KVR-CIBER/arachne-18/cad/brain_mini/fab/arachne_mini_BOM_JLCPCB.csv

Comment | Designator | Footprint | Quantity | MPN / note | LCSC Part #
AOD4185 | Q1 | TO-252-2 | 1 | AOD4185 (P-MOSFET 40 V 40 A, reverse polarity) | C400894
10k | R1,R11,R12,R17,R18,R21,R22 | R_0603_1608Metric | 7 | 0603 10k 1% | C25804
330u 25V | C1,C2 | CP_Elec_8x10.5 | 2 | 330uF 25V 8x10.5 alu, STRONGLY recommended for the servo current peaks | C350008
10u 25V / 10u | C3,C5,C6,C14 | C_0805_2012Metric | 4 | 0805 10u 25V X5R ceramic | C15850
100k | R2,R5 | R_0603_1608Metric | 2 | 0603 100k 1% | C25803
15k | R3,R9 | R_0603_1608Metric | 2 | 0603 15k 1% | C22809
100n | C4,C7,C8,C16,C18,C20,C21,C22,C23,C24,C26 | C_0603_1608Metric | 11 | 0603 100n X7R ceramic | C14663
TPS54560B | U1 | Texas_R-PDSO-G8_EP2.95x4.9mm_Mask2.4x3.1mm_ThermalVias | 1 | TPS54560BDDAR | C1850354
470k | R4 | R_0603_1608Metric | 1 | 0603 470k 1% | C23178
220k | R6 | R_0603_1608Metric | 1 | 0603 220k 1% | C22961
6.8u | L1 | L_Bourns_SRP1038C_10.0x10.0mm | 1 | Bourns SRP1038C-6R8M (6.8 uH, >= 8 A) | C20804570
SS54 | D4 | D_SMA | 1 | SS54 (5 A 40 V Schottky, JLC basic) | C22452
47u 10V | C9,C10,C11 | C_1206_3216Metric | 3 | 1206 47u 10V X5R ceramic | C96123
27k | R7 | R_0603_1608Metric | 1 | 0603 27k 1% | C22967
5k1 | R8,R27,R28 | R_0603_1608Metric | 3 | 0603 5k1 1% | C23186
4n7 | C12 | C_0603_1608Metric | 1 | 0603 4n7 X5R ceramic | C53987
47p | C13 | C_0603_1608Metric | 1 | 0603 47p X7R ceramic | C1671
LED 5V / LED ESP | D5,D8 | LED_0603_1608Metric | 2 | LED 0603 red (JLC basic) | C2286
2k2 | R10 | R_0603_1608Metric | 1 | 0603 2k2 1% | C4190
SS14 | D6,D7 | D_SMA | 2 | SS14 | C2480
AMS1117-3.3 | U2 | SOT-223-3_TabPin2 | 1 | AMS1117-3.3 | C6186
22u | C15,C17 | C_0805_2012Metric | 2 | 0805 22u X5R ceramic | C45783
ESP32-S3-WROOM-1-N16R8 | U3 | ESP32-S3-WROOM-1 | 1 | ESP32-S3-WROOM-1-N16R8 | C2913202
1k | R15,R19,R23 | R_0603_1608Metric | 3 | 0603 1k 1% | C21190
1u | C19,C29 | C_0603_1608Metric | 2 | 0603 1u X5R ceramic | C15849
74AHCT1G126 | U4,U6 | SOT-23-5 | 2 | 74AHCT1G126GW (TX driver, 5 V out) | C163712
74LVC1G34 | U5,U7 | SOT-23-5 | 2 | 74LVC1G34GW (RX buffer, 5 V tolerant) | C840096
47 | R16,R20 | R_0603_1608Metric | 2 | 0603 47 1% | C23182
L1 servo / L2 servo / L3 servo / L4 servo / L5 servo / L6 servo | J2,J3,J4,J5,J6,J7 | Molex_5267-03A_1x03_P2.50mm_Vertical | 6 | Molex 22-03-5035 / 5267-03A Mini-SPOX (mates with the 5264 plug on Feetech cables), LCSC C45581067 | C45581067
LSM6DS3TR-C | U8 | LGA-14_3x2.5mm_P0.5mm_LayoutBorder3x4y | 1 | LSM6DS3TR-C (6-axis IMU, I2C 0x6A) | C967633
4k7 | R24,R25 | R_0603_1608Metric | 2 | 0603 4k7 1% | C23162
USB-C PI | J8 | USB_C_Receptacle_HRO_TYPE-C-31-M-12 | 1 | HRO TYPE-C-31-M-12 | C165948
