KVR-CIBER/arachne-18/cad/electronics_plate/electronics_plate_v6.dxf

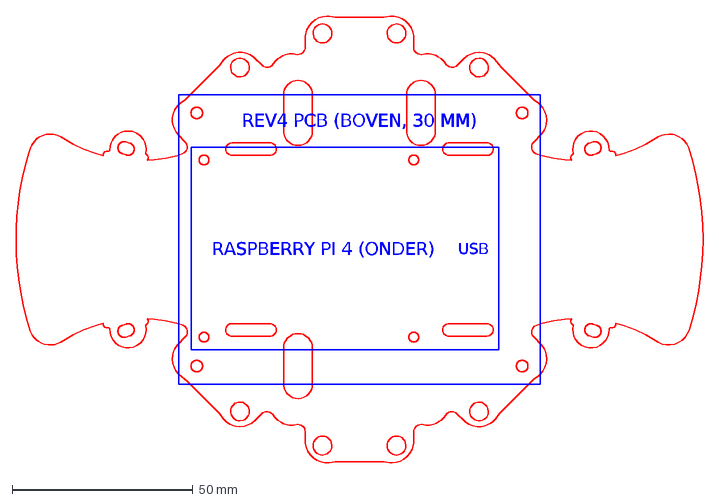
[picture p4: CAD file, 2026-11-08]
cad/electronics_plate/electronics_plate_v6.dxf
REV4 PCB (BOVEN, 30 MM)
RASPBERRY PI 4 (ONDER)
USB
