KVR-CIBER/arachne-18/cad/brain_mini/arachne_mini.kicad_pcb

## KiCad design cad/brain_mini/arachne_mini.kicad_pcb (2026-11-08)

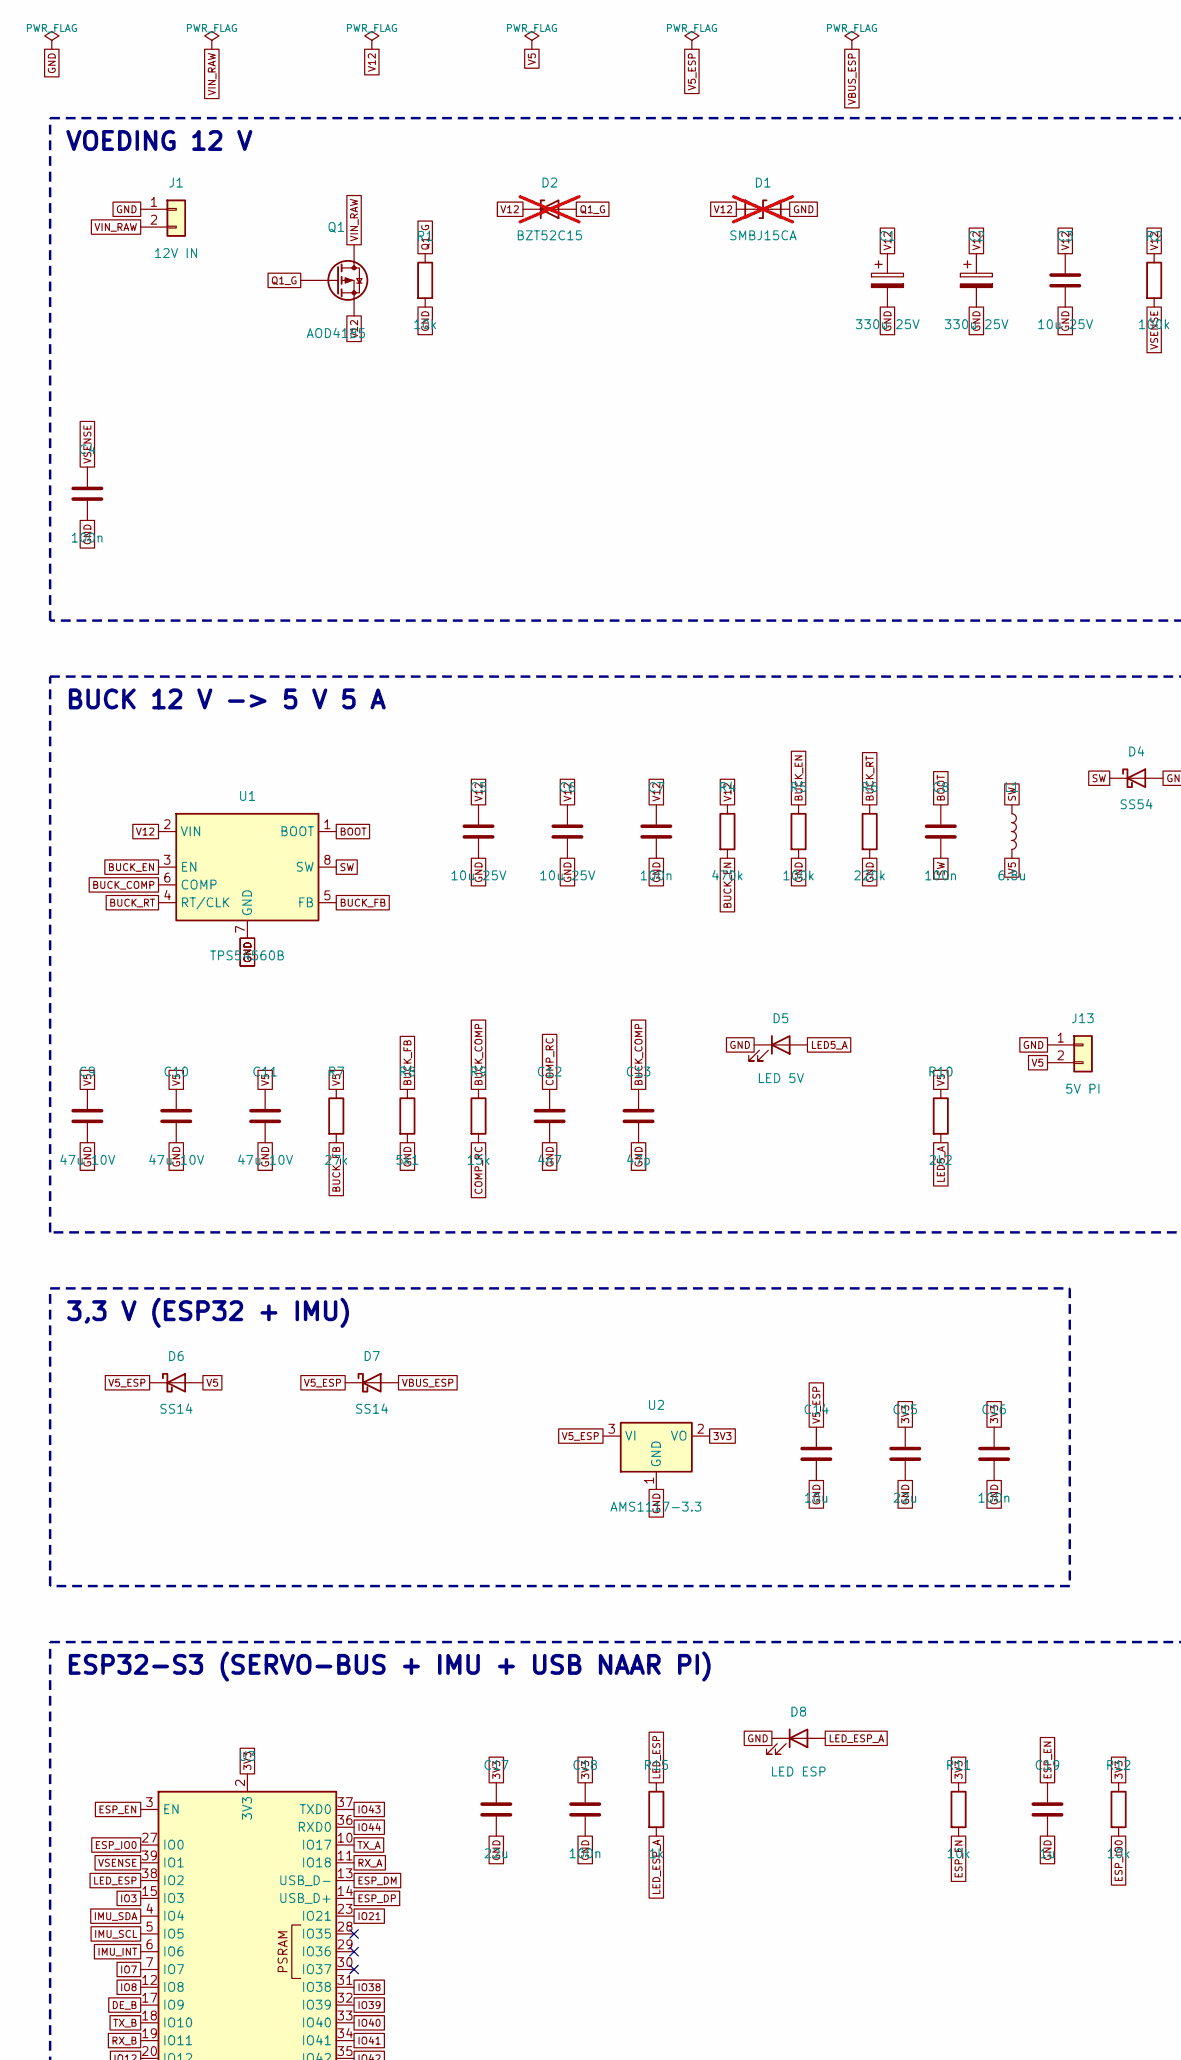
[picture p6: schematic arachne_mini.kicad_sch, ARACHNE-18 mini brain board, part in row 1, column 1]

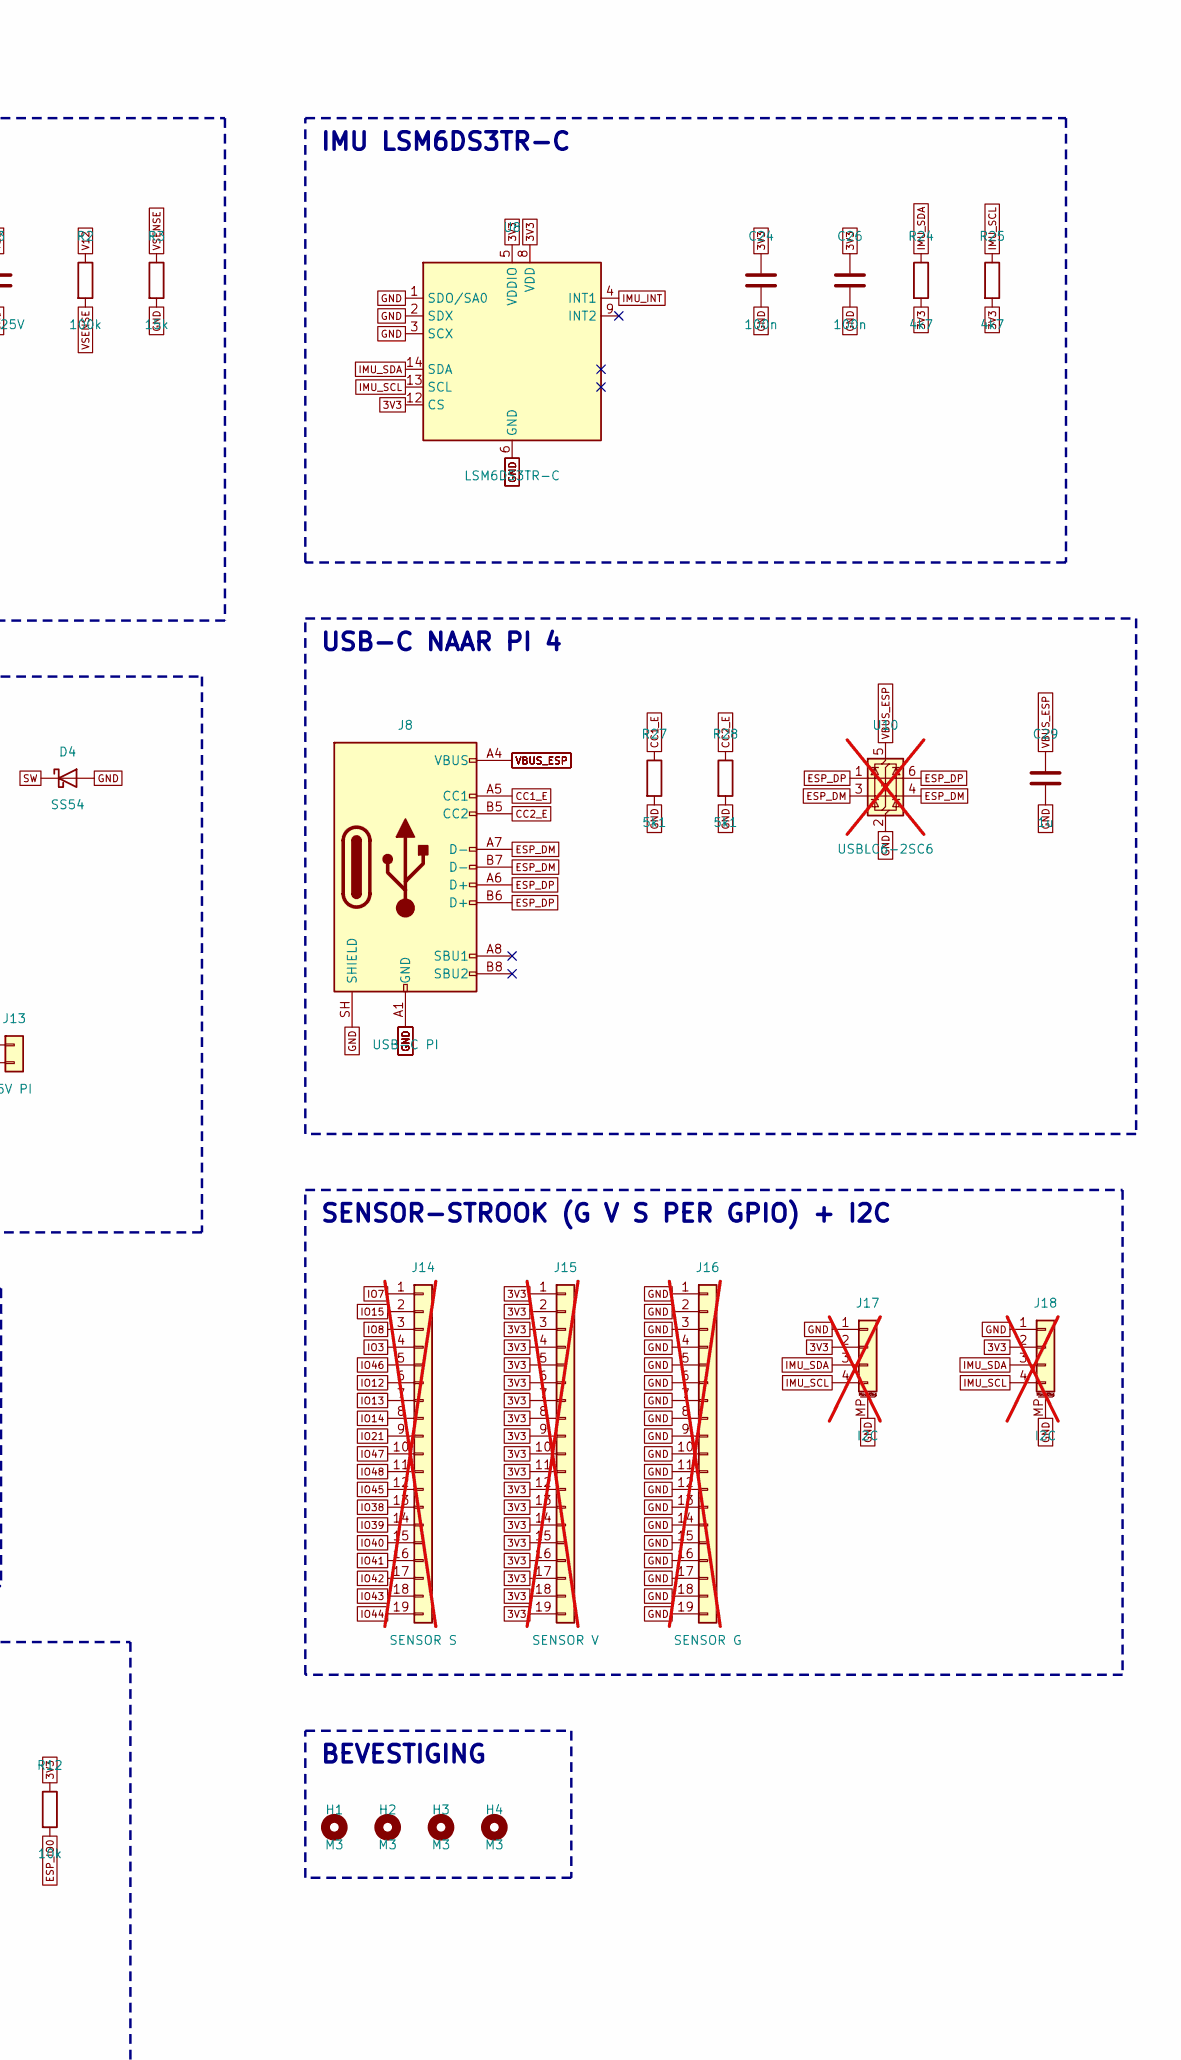
[picture p7: schematic arachne_mini.kicad_sch, ARACHNE-18 mini brain board, part in row 1, column 2]

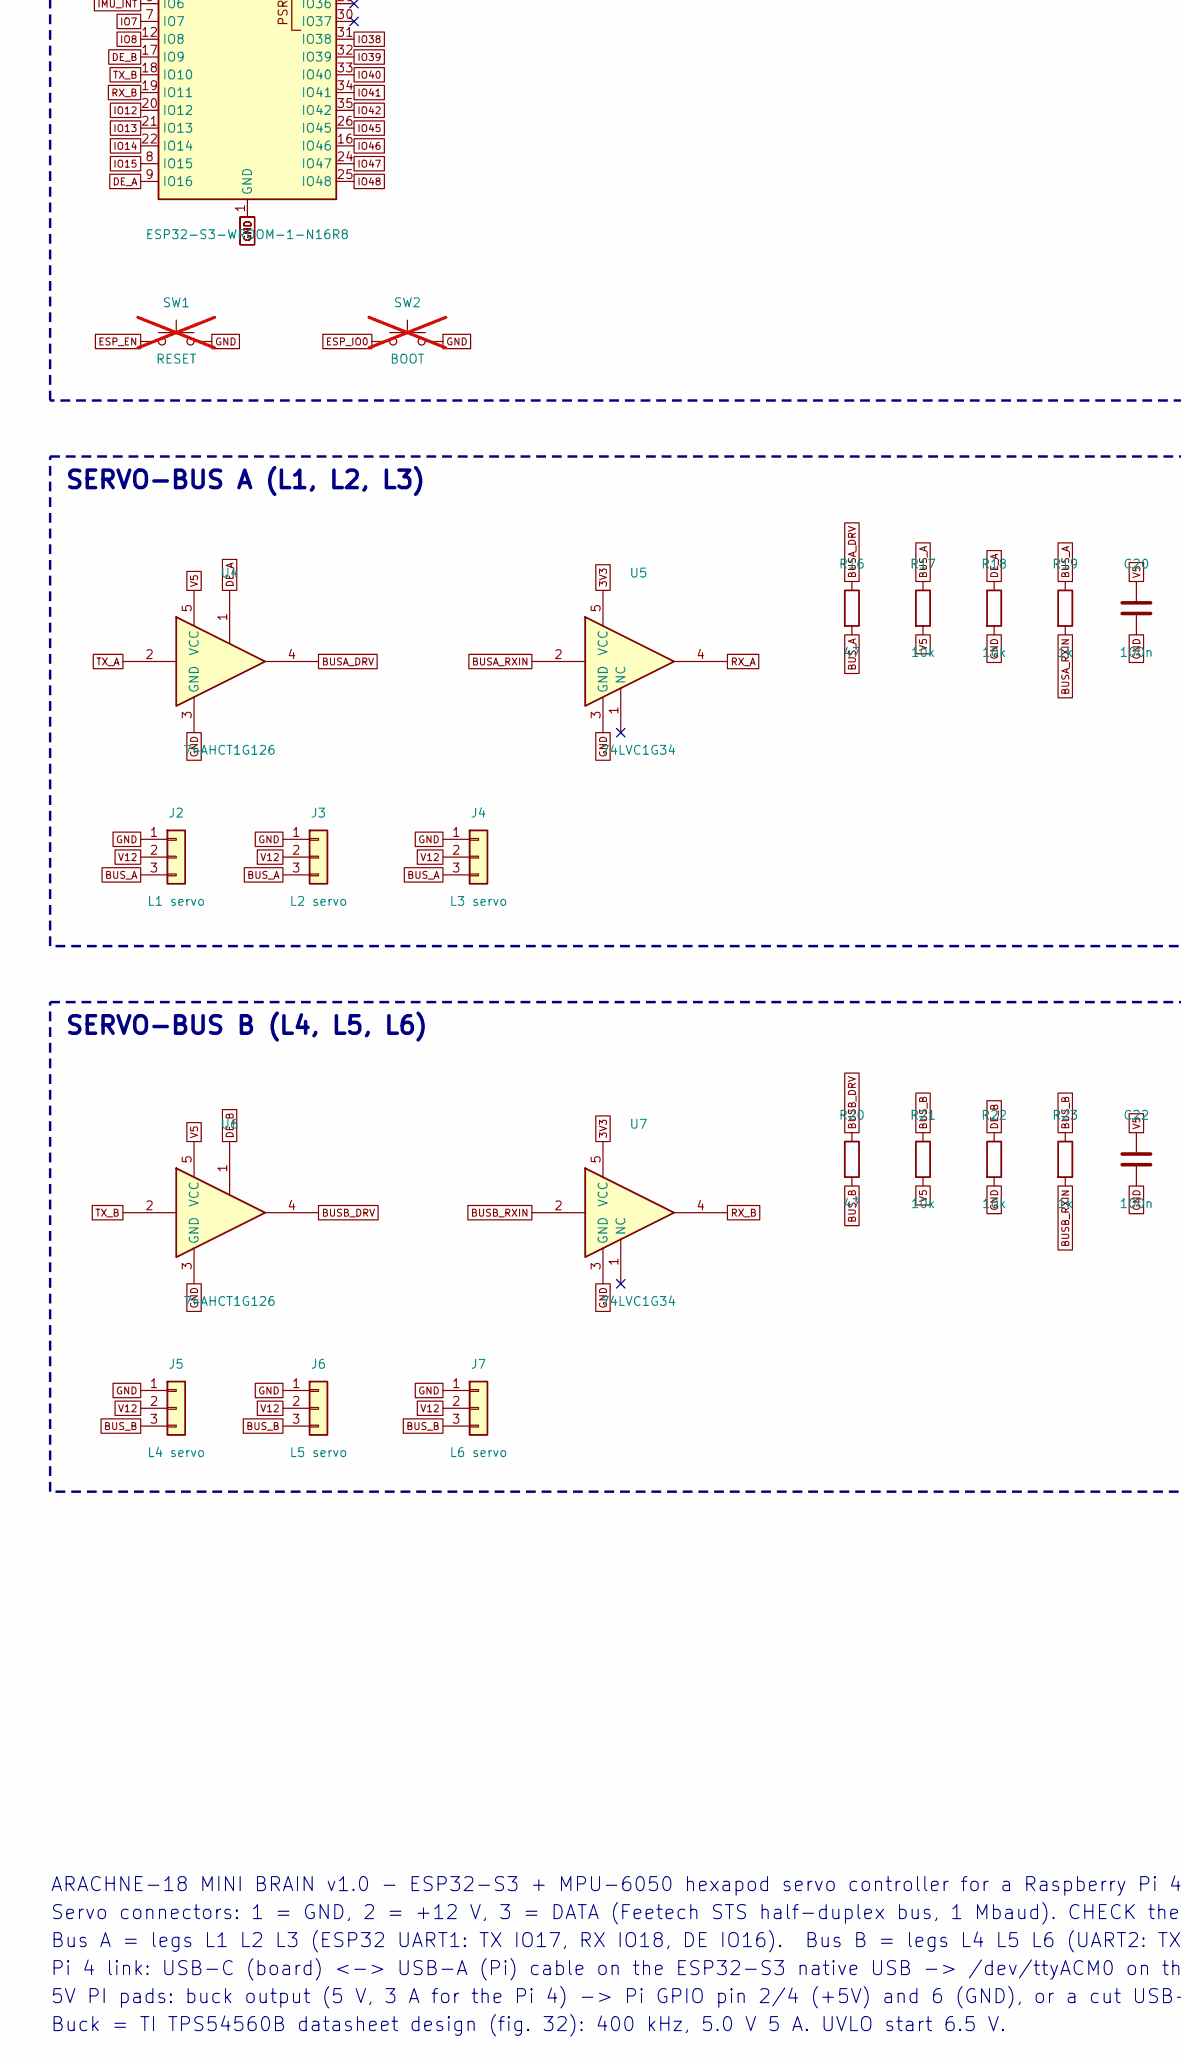
[picture p8: schematic arachne_mini.kicad_sch, ARACHNE-18 mini brain board, part in row 2, column 1]

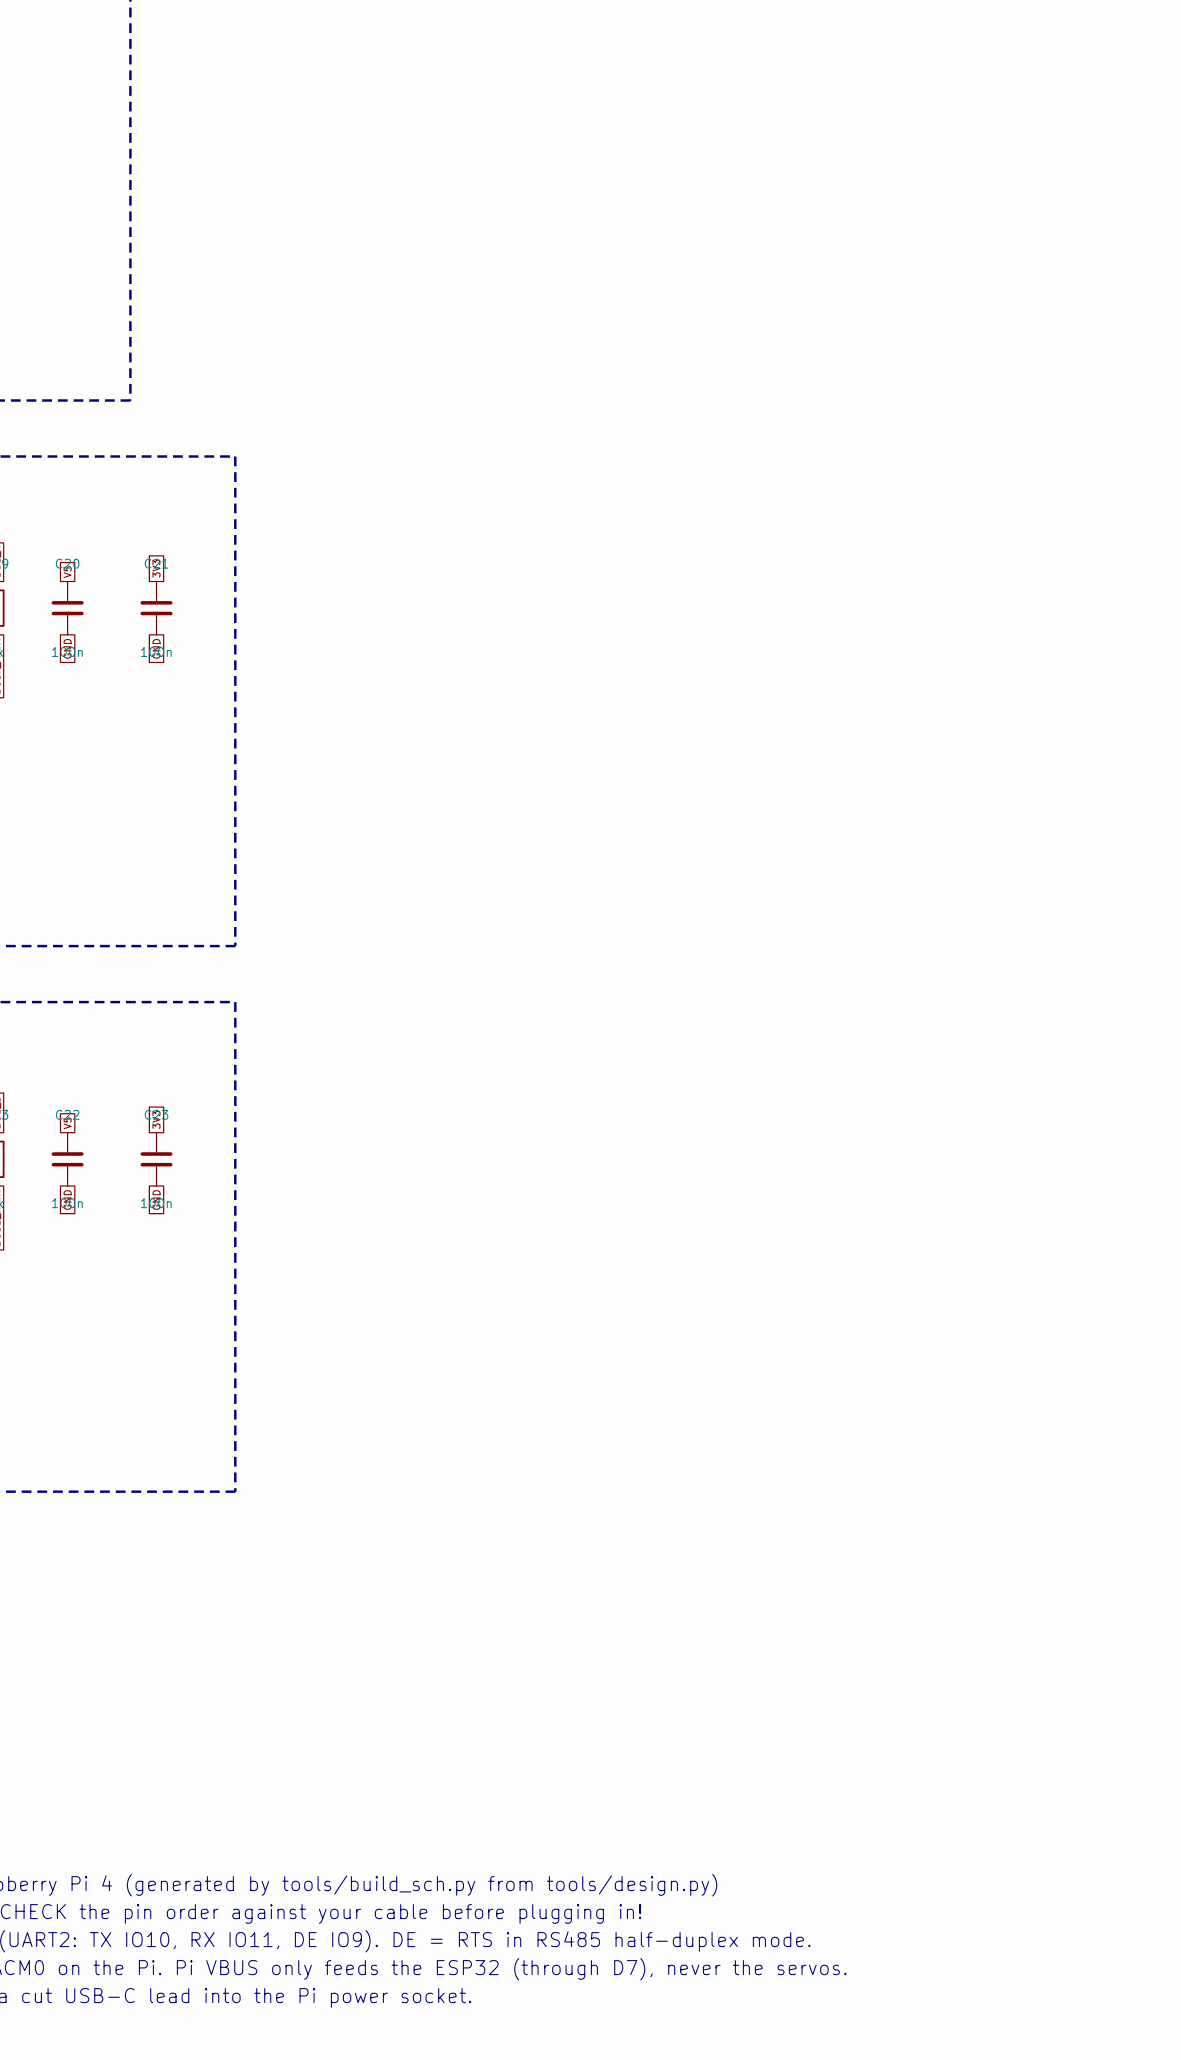
[picture p9: schematic arachne_mini.kicad_sch, ARACHNE-18 mini brain board, part in row 2, column 2]

Parts:
C1, C2: 330u 25V; CP_Elec_8x10.5; MPN 330uF 25V 8x10.5 alu, STRONGLY recommen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
C3, C5, C6: 10u 25V; C_0805_2012Metric; MPN 0805 10u 25V X5R ceramic
C4, C7, C8, C16, C18, C20, C21, C22, C23, C24, C26: 100n; C_0603_1608Metric; MPN 0603 100n X7R ceramic
C9, C10, C11: 47u 10V; C_1206_3216Metric; MPN 1206 47u 10V X5R ceramic
C12: 4n7; C_0603_1608Metric; MPN 0603 4n7 X5R ceramic
C13: 47p; C_0603_1608Metric; MPN 0603 47p X7R ceramic
C14: 10u; C_0805_2012Metric; MPN 0805 10u X5R ceramic
C15, C17: 22u; C_0805_2012Metric; MPN 0805 22u X5R ceramic
C19, C29: 1u; C_0603_1608Metric; MPN 0603 1u X5R ceramic
D1: SMBJ15CA; D_SMB; MPN SMBJ15CA TVS (optional); not fitted
D2: BZT52C15; D_SOD-123; MPN BZT52C15 gate clamp (optional: AOD4185 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; not fitted
D4: SS54; D_SMA; MPN SS54 (5 A 40 V Schottky, JLC basic)
D5: LED 5V; LED_0603_1608Metric; MPN LED 0603 red (JLC basic)
D6, D7: SS14; D_SMA; MPN SS14
D8: LED ESP; LED_0603_1608Metric; MPN LED 0603 red (JLC basic)
H1, H2, H3, H4: M3; MountingHole_3.2mm_M3
J1: 12V IN; SolderWire_2pad_P7mm_D2.2mm; MPN solder pads for 14-16 AWG
J2: L1 servo; Molex_5267-03A_1x03_P2.50mm_Vertical; MPN Molex 22-03-5035 / 5267-03A Mini-SPOX (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
J3: L2 servo; Molex_5267-03A_1x03_P2.50mm_Vertical; MPN Molex 22-03-5035 / 5267-03A Mini-SPOX (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
J4: L3 servo; Molex_5267-03A_1x03_P2.50mm_Vertical; MPN Molex 22-03-5035 / 5267-03A Mini-SPOX (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
J5: L4 servo; Molex_5267-03A_1x03_P2.50mm_Vertical; MPN Molex 22-03-5035 / 5267-03A Mini-SPOX (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
J6: L5 servo; Molex_5267-03A_1x03_P2.50mm_Vertical; MPN Molex 22-03-5035 / 5267-03A Mini-SPOX (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
J7: L6 servo; Molex_5267-03A_1x03_P2.50mm_Vertical; MPN Molex 22-03-5035 / 5267-03A Mini-SPOX (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
J8: USB-C PI; USB_C_Receptacle_HRO_TYPE-C-31-M-12; MPN HRO TYPE-C-31-M-12
J13: 5V PI; SolderWire_2pad_P5mm_D1.6mm_5V; MPN solder pads: 5 V 3 A to the Pi 4 (GPIO 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
J14: SENSOR S; PinHeader_1x19_P2.54mm_Vertical; MPN 1x19 pin header 2.54 mm (row S of the s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; not fitted
J15: SENSOR V; PinHeader_1x19_P2.54mm_Vertical; MPN 1x19 pin header 2.54 mm (row V of the s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; not fitted
J16: SENSOR G; PinHeader_1x19_P2.54mm_Vertical; MPN 1x19 pin header 2.54 mm (row G of the s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; not fitted
J17, J18: I2C; JST_SH_SM04B-SRSS-TB_1x04-1MP_P1.00mm_Horizontal; MPN JST SM04B-SRSS-TB (Qwiic / STEMMA QT, o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; not fitted
L1: 6.8u; L_Bourns_SRP1038C_10.0x10.0mm; MPN Bourns SRP1038C-6R8M (6.8 uH, >= 8 A)
Q1: AOD4185; TO-252-2; MPN AOD4185 (P-MOSFET 40 V 40 A, reverse po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
R1, R11, R12, R17, R18, R21, R22: 10k; R_0603_1608Metric; MPN 0603 10k 1%
R2, R5: 100k; R_0603_1608Metric; MPN 0603 100k 1%
R3, R9: 15k; R_0603_1608Metric; MPN 0603 15k 1%
R4: 470k; R_0603_1608Metric; MPN 0603 470k 1%
R6: 220k; R_0603_1608Metric; MPN 0603 220k 1%
R7: 27k; R_0603_1608Metric; MPN 0603 27k 1%
R8, R27, R28: 5k1; R_0603_1608Metric; MPN 0603 5k1 1%
R10: 2k2; R_0603_1608Metric; MPN 0603 2k2 1%
R15, R19, R23: 1k; R_0603_1608Metric; MPN 0603 1k 1%
R16, R20: 47; R_0603_1608Metric; MPN 0603 47 1%
R24, R25: 4k7; R_0603_1608Metric; MPN 0603 4k7 1%
SW1: RESET; SW_Push_1P1T_NO_CK_KMR2; MPN CK KMR221G (4.2x2.8 tact); the S3 flash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; not fitted
SW2: BOOT; SW_Push_1P1T_NO_CK_KMR2; MPN CK KMR221G (4.2x2.8 tact); the S3 flash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; not fitted
U1: TPS54560B; Texas_R-PDSO-G8_EP2.95x4.9mm_Mask2.4x3.1mm_ThermalVias; MPN TPS54560BDDAR
U2: AMS1117-3.3; SOT-223-3_TabPin2; MPN AMS1117-3.3
U3: ESP32-S3-WROOM-1-N16R8; ESP32-S3-WROOM-1; MPN ESP32-S3-WROOM-1-N16R8
U4, U6: 74AHCT1G126; SOT-23-5; MPN 74AHCT1G126GW (TX driver, 5 V out)
U5, U7: 74LVC1G34; SOT-23-5; MPN 74LVC1G34GW (RX buffer, 5 V tolerant)
U8: LSM6DS3TR-C; LGA-14_3x2.5mm_P0.5mm_LayoutBorder3x4y; MPN LSM6DS3TR-C (6-axis IMU, I2C 0x6A)
U10: USBLC6-2SC6; SOT-23-6; MPN USBLC6-2SC6 ESD (optional); not fitted

Connections:
3V3: C15.1, C16.1, C17.1, C18.1, C21.1, C23.1, C24.1, C26.1, J15.1, J15.2, J15.3, J15.4, J15.5, J15.6, J15.7, J15.8, J15.9, J15.10, J15.11, J15.12, J15.13, J15.14, J15.15, J15.16, J15.17, J15.18, J15.19, J17.2, J18.2, R11.1, R12.1, R24.2, R25.2, U2.2 (VO), U3.2 (3V3), U5.5 (VCC), U7.5 (VCC), U8.5 (VDDIO), U8.8 (VDD), U8.12 (CS)
BOOT: C8.1, U1.1 (BOOT)
BUCK_COMP: C13.1, R9.1, U1.6 (COMP)
BUCK_EN: R4.2, R5.1, U1.3 (EN)
BUCK_FB: R7.2, R8.1, U1.5 (FB)
BUCK_RT: R6.1, U1.4 (RT/CLK)
BUSA_DRV: R16.1, U4.4
BUSA_RXIN: R19.2, U5.2
BUSB_DRV: R20.1, U6.4
BUSB_RXIN: R23.2, U7.2
BUS_A: J2.3, J3.3, J4.3, R16.2, R17.1, R19.1
BUS_B: J5.3, J6.3, J7.3, R20.2, R21.1, R23.1
CC1_E: J8.A5 (CC1), R27.1
CC2_E: J8.B5 (CC2), R28.1
COMP_RC: C12.1, R9.2
DE_A: R18.1, U3.9 (IO16), U4.1
DE_B: R22.1, U3.17 (IO9), U6.1
ESP_DM: J8.A7 (D-), J8.B7 (D-), U3.13 (USB_D-), U10.3 (I/O2), U10.4 (I/O2)
ESP_DP: J8.A6 (D+), J8.B6 (D+), U3.14 (USB_D+), U10.1 (I/O1), U10.6 (I/O1)
ESP_EN: C19.1, R11.2, SW1.1, U3.3 (EN)
ESP_IO0: R12.2, SW2.1, U3.27 (IO0)
GND: C1.2, C2.2, C3.2, C4.2, C5.2, C6.2, C7.2, C9.2, C10.2, C11.2, C12.2, C13.2, C14.2, C15.2, C16.2, C17.2, C18.2, C19.2, C20.2, C21.2, C22.2, C23.2, C24.2, C26.2, C29.2, D1.2 (A2), D4.2 (A), D5.1 (K), D8.1 (K), J1.1, J2.1, J3.1, J4.1, J5.1, J6.1, J7.1, J8.A1 (GND), J8.A12 (GND), J8.B1 (GND), J8.B12 (GND), J8.SH (SHIELD), J13.1, J16.1, J16.2, J16.3, J16.4, J16.5, J16.6, J16.7, J16.8, J16.9, J16.10, J16.11, J16.12, J16.13, J16.14, J16.15, J16.16, J16.17, J16.18, J16.19, J17.1, J17.MP (MountPin), J18.1, J18.MP (MountPin), R1.2, R3.2, R5.2, R6.2, R8.2, R18.2, R22.2, R27.2, R28.2, SW1.2, SW2.2, U1.7 (GND), U1.9 (GND), U2.1 (GND), U3.1 (GND), U3.40 (GND), U3.41 (GND), U4.3 (GND), U5.3 (GND), U6.3 (GND), U7.3 (GND), U8.1 (SDO/SA0), U8.2 (SDX), U8.3 (SCX), U8.6 (GND), U8.7 (GND), U10.2 (GND)
IMU_INT: U3.6 (IO6), U8.4 (INT1)
IMU_SCL: J17.4, J18.4, R25.1, U3.5 (IO5), U8.13 (SCL)
IMU_SDA: J17.3, J18.3, R24.1, U3.4 (IO4), U8.14 (SDA)
IO3: J14.4, U3.15 (IO3)
IO7: J14.1, U3.7 (IO7)
IO8: J14.3, U3.12 (IO8)
IO12: J14.6, U3.20 (IO12)
IO13: J14.7, U3.21 (IO13)
IO14: J14.8, U3.22 (IO14)
IO15: J14.2, U3.8 (IO15)
IO21: J14.9, U3.23 (IO21)
IO38: J14.13, U3.31 (IO38)
IO39: J14.14, U3.32 (IO39)
IO40: J14.15, U3.33 (IO40)
IO41: J14.16, U3.34 (IO41)
IO42: J14.17, U3.35 (IO42)
IO43: J14.18, U3.37 (TXD0)
IO44: J14.19, U3.36 (RXD0)
IO45: J14.12, U3.26 (IO45)
IO46: J14.5, U3.16 (IO46)
IO47: J14.10, U3.24 (IO47)
IO48: J14.11, U3.25 (IO48)
LED5_A: D5.2 (A), R10.2
LED_ESP: R15.1, U3.38 (IO2)
LED_ESP_A: D8.2 (A), R15.2
Q1_G: D2.2 (A), Q1.1 (G), R1.1
RX_A: U3.11 (IO18), U5.4
RX_B: U3.19 (IO11), U7.4
SW: C8.2, D4.1 (K), L1.1, U1.8 (SW)
TX_A: U3.10 (IO17), U4.2
TX_B: U3.18 (IO10), U6.2
V5: C9.1, C10.1, C11.1, C20.1, C22.1, D6.2 (A), J13.2, L1.2, R7.1, R10.1, R17.2, R21.2, U4.5 (VCC), U6.5 (VCC)
V5_ESP: C14.1, D6.1 (K), D7.1 (K), U2.3 (VI)
V12: C1.1, C2.1, C3.1, C5.1, C6.1, C7.1, D1.1 (A1), D2.1 (K), J2.2, J3.2, J4.2, J5.2, J6.2, J7.2, Q1.3 (S), R2.1, R4.1, U1.2 (VIN)
VBUS_ESP: C29.1, D7.2 (A), J8.A4 (VBUS), J8.A9 (VBUS), J8.B4 (VBUS), J8.B9 (VBUS), U10.5 (VBUS)
VIN_RAW: J1.2, Q1.2 (D)
VSENSE: C4.1, R2.2, R3.1, U3.39 (IO1)

Notes on the sheet:
VOEDING 12 V
BUCK 12 V -> 5 V 5 A
3,3 V (ESP32 + IMU)
ESP32-S3 (SERVO-BUS + IMU + USB NAAR PI)
SERVO-BUS A (L1, L2, L3)
SERVO-BUS B (L4, L5, L6)
IMU LSM6DS3TR-C
USB-C NAAR PI 4
SENSOR-STROOK (G V S PER GPIO) + I2C
BEVESTIGING
ARACHNE-18 MINI BRAIN v1.0 - ESP32-S3 + MPU-6050 hexapod servo controller for a Raspberry Pi 4 (generated by tools/build_sch.py from tools/design.py)
Servo connectors: 1 = GND, 2 = +12 V, 3 = DATA (Feetech STS half-duplex bus, 1 Mbaud). CHECK the pin order against your cable before plugging in!
Bus A = legs L1 L2 L3 (ESP32 UART1: TX IO17, RX IO18, DE IO16). Bus B = legs L4 L5 L6 (UART2: TX IO10, RX IO11, DE IO9). DE = RTS in RS485 half-duplex mode.
Pi 4 link: USB-C (board) <-> USB-A (Pi) cable on the ESP32-S3 native USB -> /dev/ttyACM0 on the Pi. Pi VBUS only feeds the ESP32 (through D7), never the servos.
5V PI pads: buck output (5 V, 3 A for the Pi 4) -> Pi GPIO pin 2/4 (+5V) and 6 (GND), or a cut USB-C lead into the Pi power socket.
Buck = TI TPS54560B datasheet design (fig. 32): 400 kHz, 5.0 V 5 A. UVLO start 6.5 V.

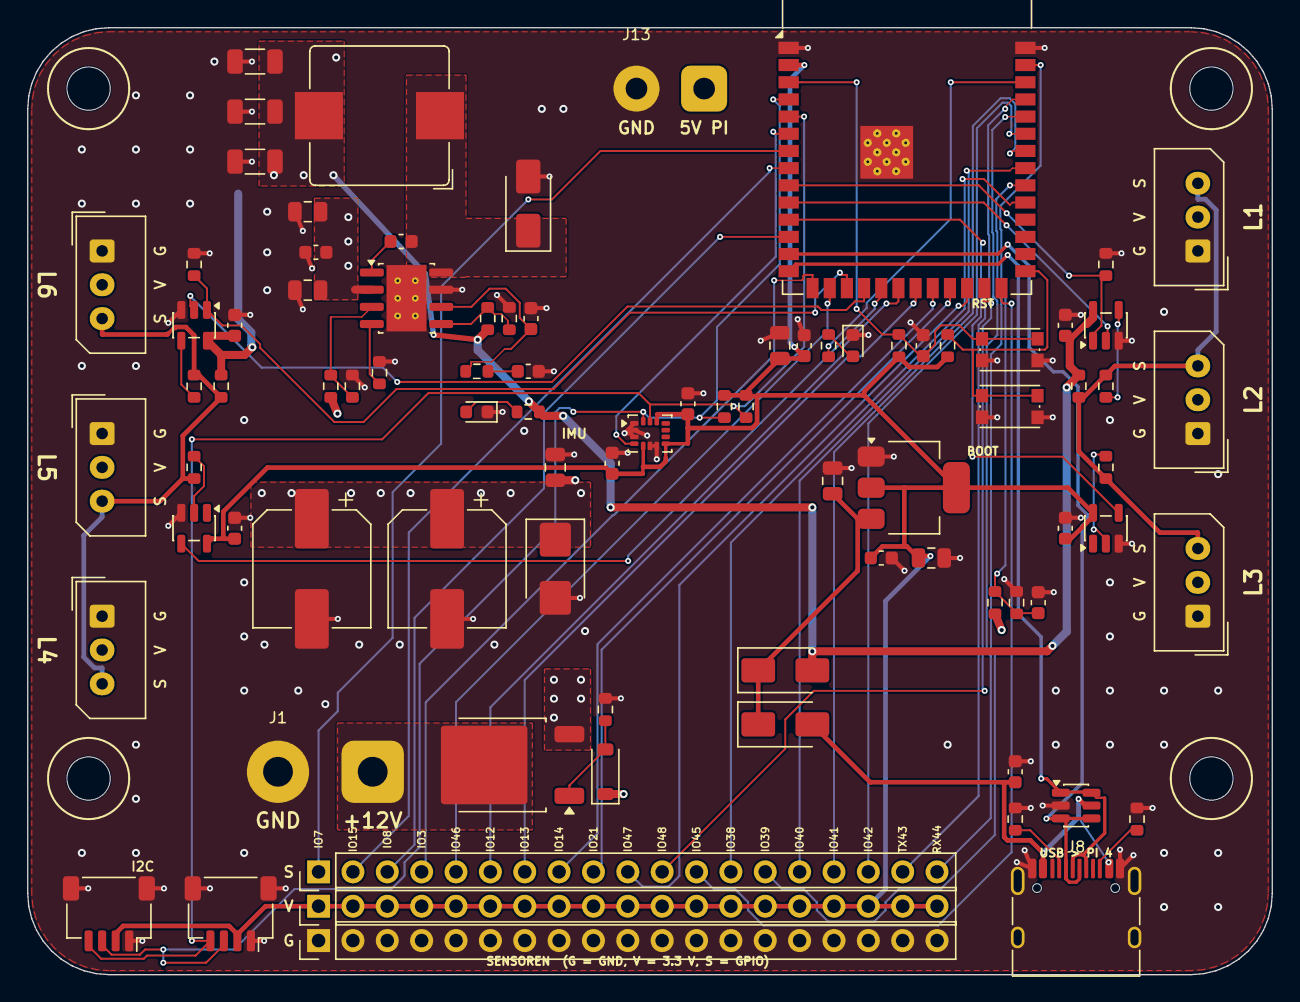
[picture p10: board arachne_mini.kicad_pcb from above]

Board: 4 copper layers, 92.0 x 70.0 mm, 89 parts (0 on the bottom side), 59 nets.
