KVR-CIBER/arachne-18/(commit log)

2026-11-08 brain_mini: sensor headers J14-J16 placed by JLC (C2932706, THT), everything on the board; rotation rule for 1xN headers
    [arachne_mini-B_Cu.gbr, arachne_mini-B_Mask.gbr, arachne_mini-B_Paste.gbr, arachne_mini-B_Silkscreen.gbr, arachne_mini-Edge_Cuts.gbr, arachne_mini-F_Cu.gbr, arachne_mini-F_Mask.gbr, arachne_mini-F_Paste.gbr]
2026-11-08 brain_mini: cheapest JLC order - optional parts (D1 D2 U10 J17 J18 SW1 SW2) and sensor headers J14-J16 hand-solder/DNP
    [arachne_mini-B_Cu.gbr, arachne_mini-B_Mask.gbr, arachne_mini-B_Paste.gbr, arachne_mini-B_Silkscreen.gbr, arachne_mini-Edge_Cuts.gbr, arachne_mini-F_Cu.gbr, arachne_mini-F_Mask.gbr, arachne_mini-F_Paste.gbr]
2026-11-08 Plexi plate v6: Raspberry Pi 4 + CNC-milled Hexapod Rev4 PCB, stacked
    The Rev4 PCB (100 x 80, 4x M3 on 90 x 70) and the Pi 4 do not fit side by side,
    so the Pi lies on the plate and the Rev4 sits above it on M3 x 30 mm spacers.
    DXF, SVG, LightBurn project and preview.
    [electronics_plate_v6.dxf]
